nacaceresp/PetMachine/Prefactibilidad.xlsx

Sheet: Costos no fijos
 |  | Frecuencia (dias) | Costo unitario | Costo mensual | Comentarios | Agua
Mantenimiento | Motor 1 | 375 | $70000 | $4853.333333 |  | Agua por botella (ml) | 250
 | Motor 2 | 375 | $70000 | $4853.333333 |  | # botellas | 64
 | Cuchilla | 1 | $1000 | $26000 |  | Agua por dia (ml) | 16000
 |  |  |  |  |  | Precio por m^3 de agua | $5000
 | Boquilla de extrusor | 15 | $5000 | $8666.666667 | https://www.google.com/search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 | Precio servicio por dia | $80
 | Engranajes | 1 | $0 | $0 |  | Suscripcion (2 meses) | $25000
 | Tensor | 1 | $0 | $0 |  | Precio total por mes | $14580
Salarios | Operario | 30 | NA | $2000000
Servicios | Agua | 30 | NA | $14580 | Consumo comercial (https://www.acueducto.com.co/wps/portal/EAB2/Home/atencion-al-usuario/tarifas/tarifas2023) | Electricidad
 | Electricidad | 30 | NA | $32214 | Sector residencial estrato 4 propiedad del cliente | Consumo pistola de calor (kW) | 0.18
 | Barsol | 30 | NA | $65312 |  | Consumo motores
Costo total |  |  |  | $2156479.333 |  | Consumo controlador | 0.00125 | PIC18FF4550 a 5v
 |  |  |  |  |  | Consumo extrusor | 0.04
 |  |  |  |  |  | Consumo total | 0.22125
 |  |  |  |  |  | Precio kWh | $700
 |  |  |  |  |  | Precio por dia | $1239
 |  |  |  |  |  | Precio por mes | $32214
 |  |  |  |  |  | Barsol
 |  |  |  |  |  | Barsol por botella (ml) | 5
 |  |  |  |  |  | # botellas | 64
 |  |  |  |  |  | Consumo por dia (ml) | 320
 |  |  |  |  |  | Litro de barsol | $7850 | https://llanoquimicos.com/es/productos/varsol-ab7fc903-5bc0-475b-a58f-7d4d634aad5d
 |  |  |  |  |  | Precio por dia | $2512
 |  |  |  |  |  | Precio por mes | $65312

Sheet: Estimación Motores
 | Corte | Inercia Carrete |  |  | cm
Tensión (N) | 20 | Densidad (g/cm^3) | 1.38 | 1 | 19.5
Velocidad(cm/s) | 5 | Volumen del rodillo (cm^3) | 101.6108874 | 2 | 6
Diametro (cm) | 14.75 | Espesor de tapa (cm) | 0.35 | 3 | 7.2
Velocidad angular rad/s | 0.6779661017 | Volumen de tapas (cm^3) | 368.3910085 | 4 | 7
RPM | 6.474084241 | Inercia del rodillo (g-cm^2) | 7070.0449
Torque (N-m) | 1.475 | Inercia de tapas (g-cm^2) | 109110.9699
Potencia | 1 | Inercia del rodillo (kg-m^2) | 0.00070700449
 |  | Inercia de tapas (kg-m^2) | 0.01091109699
Relación de inercia | 9.147699406 | Inercia de carrete (g-cm^2) | 116181.0148
Relación de inercia | 0.1093171032 | Inercia de carrete (kg-m^2) | 0.01161810148
Relación de inercia | 0.1093171032 | Diametro del eje (cm) | 0.2
 |  | Largo del eje (cm) | 0.6
 |  | Densidad (g/cm^3) | 8
 | 1.31180509e-07 | Volumen del eje (cm^3) | 0.01884955592
Relacion inercia motor | 0.0000012 | Inercia del eje(g-cm^2) | 0.003015928947
 | 0.1093170909
 |  | InerciaMotorEscogido(kg*m^2) | 0.1062789000
 |  | InerciaMotorEscogido(g*cm^2) | 1062789
 | 38522464.16
Extrusion
Tensión (N) | 60 | Inercia motor 2
Velocidad(cm/s) | 2 | Diametro del eje (cm) | 0.6
Diametro (cm) | 17 | Largo del eje (cm) | 1.5 | motor
Radio (cm) | 8.5 | Densidad (g/cm^3) | 8
Velocidad angular rad/s | 0.2352941176 | Volumen del eje (cm^3) | 0.4241150082
RPM | 2.24688806 | Inercia del eje(g-cm^2) | 0.6107256119
Torque (N-m) | 5.1 | Inercia de eje (kg-m^2) | 6.107256119e-08
Potencia de salida | 1.2
 |  | Relación de inercia motor 2
 |  | Relación de transmisión | 75
 |  | Relación de inercia | 33.81944727
 |  | Torque de entrada (Nm) | 0.068
 |  | RPM de entrada | 168.5166045
 |  | Potencia entrada W | 1.304347826

Sheet: BOM
 | Num | Nombre | Descripción | Proveedor | Referencia | Cantidad | Unidad | Precio unitario | Precio total | Links
Pretratamiento | 1 | Compresor de aire |  |  |  | 1 | por unidad | $39900.00 | $39900.00 | https://articulo.mercadolibre.com.co/MCO-991857448-compresor-aire-portatil-infla-llantas-y-neumaticos-dc-12v-_JM
 | 2 | Pistola de calor |  |  |  | 1 | por unidad | $99900.00 | $99900.00 | https://articulo.mercadolibre.com.co/MCO-454319437-pistola-de-calor-1800w-2-temperaturas-50-550c-250-500-l-_JM
Corte | 3 | Cuchilla |  |  |  | 1 | por paquete de 6 | $6000.00 | $6000.00
 | 4 | Tornillo 5/16x2-1/2 Mariposa |  |  |  | 1 | por 2 unidades | $4900.00 | $4900.00 | https://www.homecenter.com.co/homecenter-co/product/73940/tornillo-hexagonal-5-16x1-1-2-3un/73940/
 | 5 | Arandela 5/16 |  |  |  | 1 | por 6 unidades | $4400.00 | $4400.00 | https://www.homecenter.com.co/homecenter-co/product/71378/arandela-plana-5-16-6un/71378/
 | 6 | Tuercas 5/16 |  |  |  | 2 | por unidad | $200.00 | $400.00 | https://ferricentro.com/producto/tuerca-seguridad-ro-5-16/
 | 7 | Motor DC |  |  |  | 1 | por unidad | $70000.00 | $70000.00 | https://www.didacticaselectronicas.com/index.php/elementos-electromecanicos/motores-y-solenoides-1/motores-ac/motor-115vac-5-6-rpm-motores-ac-motor-s%C3%ADncr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
 | 8 | Engranes |  |  |  |  |  |  | $0.00
Extrusión | 9 | Hotend extrusor |  |  |  | 1 | por unidad | $45600.00 | $45600.00 | https://www.vistronica.com/impresora-3d-y-cnc/extrusor/extrusor-hotend-v6-impresora-3d-1-75mm-boquilla-0-3mm-largo-alcance-detail.html
 | 10 | Tornillos M5 |  |  |  | 1 | por 6 unidades | $1000.00 | $1000.00 | https://www.bigtronica.com/robotica-kit-s/tornillos-tuercas/2151-tornillo-m5-10mm-6-unidades-5053212021511.html
 | 11 | Arandela M5 |  |  |  | 1 | por unidad | $235.65 | $235.65 | https://www.didacticaselectronicas.com/index.php/cnc-e-impresoras-3d/estructura/tuercas-y-tornillos/arandelas-y-separadores/arandela-para-tornillo-m4-y-m5-ara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
 | 12 | Tuerca M5 |  |  |  | 1 | por 6 unidades | $500.00 | $500.00 | https://www.bigtronica.com/robotica-kit-s/tornillos-tuercas/2160-tuerca-hexagonal-acero-inoxidable-m5-6-unidades-5053212021603.html
 | 13 | Microcontrolador |  |  |  | 1 | por unidad | $130000.00 | $130000.00 | https://articulo.mercadolibre.com.co/MCO-865605018-microcontrolador-pic-18f4550-pic18f4550-ip-40-pines-_JM
Enrollado | 14 | Motor DC |  |  |  | 1 | por unidad | $70000.00 | $70000.00
 | 15 | Carrete |  |  |  | 3 | por unidad | $25000.00 | $75000.00
 | 18 | Engranajes |  |  |  |  |  |  | $0.00
 |  | Tensor |  |  |  | 1 | por unidad | $60000.00 | $60000.00
Otros | 20 | Coste de impresión |  |  |  | 1 |  | $700000.00 | $700000.00
 |  | Maquinado de piezas |  |  |  |  |  | $0.00 | $0.00
 |  | PLA |  |  |  | 1.4 | por kilo | $126000.00 | $176400.00
 |  |  |  |  |  |  |  | Costo del Proyecto | $1307835.65

Sheet: Calculo produccion
Inversión en maquina | $1307835.65 | Datos asumidos
Costo de operación mensual | $2156479.333 | peso de botella (g) | 17
Meses para recuperar inversion | 6 | Metros por kilo | 350
Recuperacion de inversion mensual | $217972.6083
Produccion necesaria mensual | $2374451.942
Precio de venta filamento por kilo | $80000
# kilos necesarios al dia (menos domingos) | 1.14
# de botellas procesadas al dia | 67.15079021
# de botellas procesadas al mes | 1745.920545
Tiempo maximo por etapa en minutos (tasa a la que procesamos cada botella) | 7.15
Velocidad de enrolle minima (cm/s) | 1.39
Velocidad de enrolle deseada (cm/s) | 3
# kilos por dia | 2.468571429
Precio de manufactura de cada carrete | $33598.99246
Tiempo por carrete de 1Kg (horas) | 8.009066228
Numero de botellas por carrete asumiendo 9 gramos de pet sacado por botella | 111.1111111
Tiempo por botella (mins) | 4.324895763
Metros aproximados de tira por botella | 3.6
Area de tira = largo de tira x alto de tira
Area cilindro (de la parte media de una botella de 600ml)
Diametro mm | 63
altura de cilindor | 150

Sheet: Tecnica
Velocidad Angular (rpm) | 0.5 | 3 | Datos asumidos
Velocidad Angular (rad/s) | 0.05235987756 | 0.3141592654 | Metros por botella | 5
Radio de engrane (cm) | 5 | 5
Velocidad lineal(cm/s) | 0.2617993878 | 1.570796327
Demora de extruir una botella en minutos | 31.83098862 | 5.30516477
