nacaceresp/PetMachine/PCB/Esquema de conexiones PCB.pdf

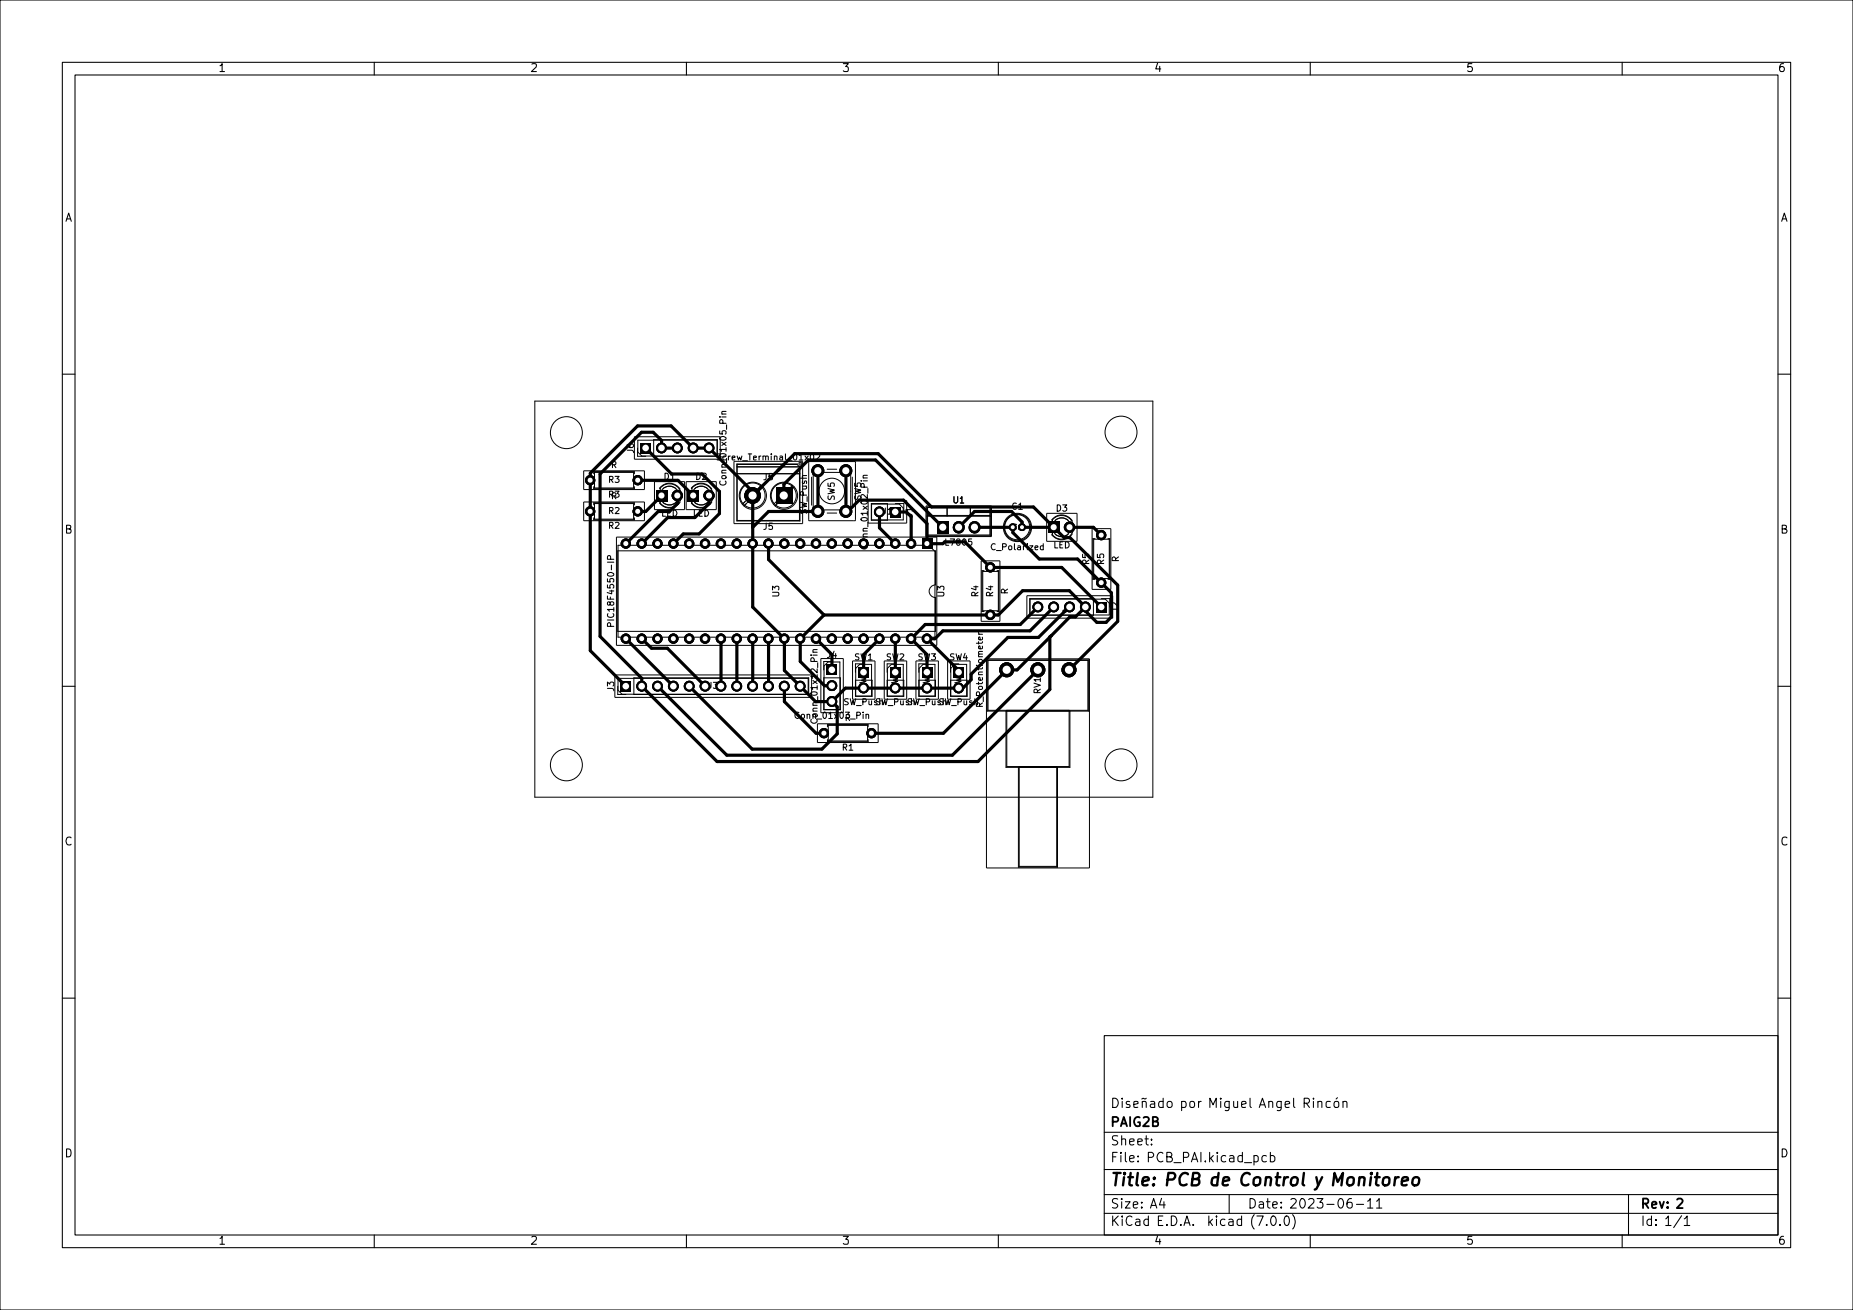
[picture p1: page 1]
