nacaceresp/PetMachine/PCB/Plano electrขnico.pdf

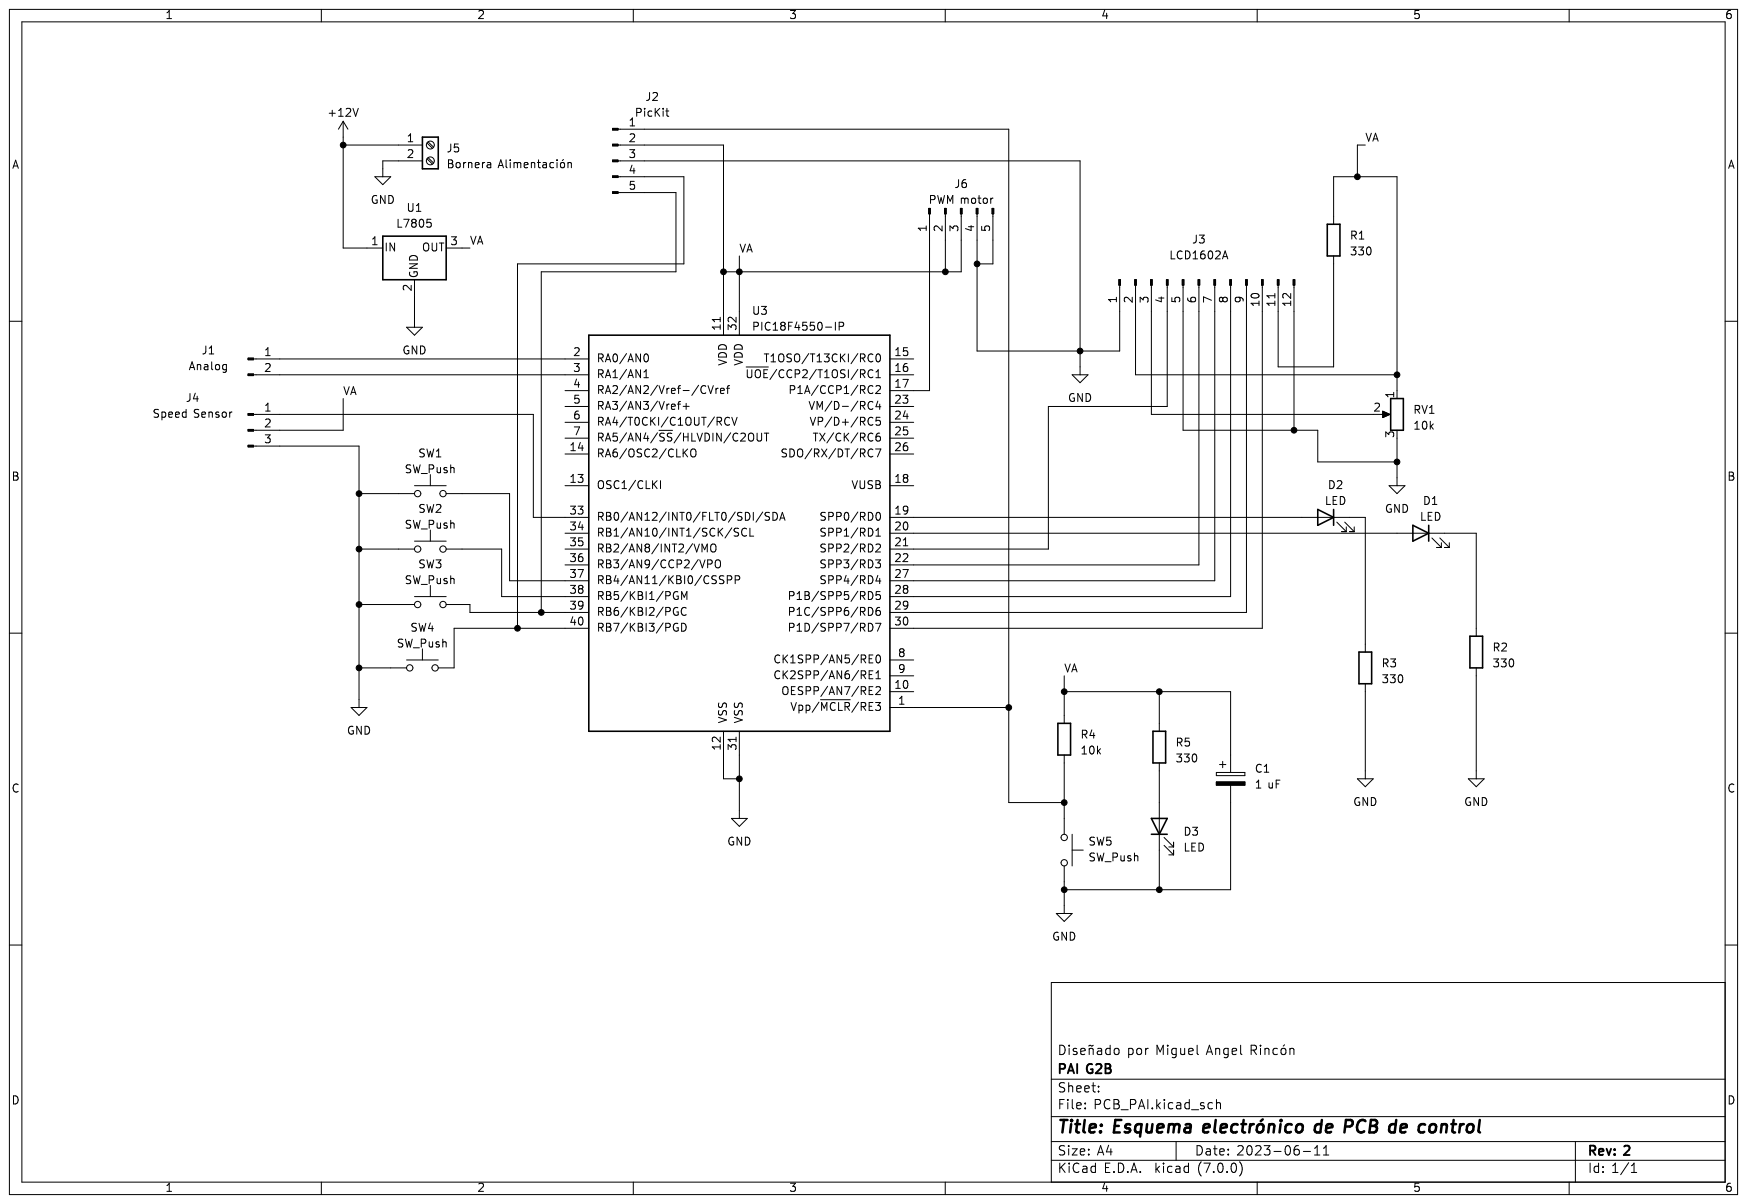
[picture p2: page 1]
