nacaceresp/PetMachine/(list of files, drawings)

Other design files:
PCB/InterfazPAI.pdsprj
